saadcaffeine/dbdc/docs/related-projects.md

---
title: Related projects and products
nav_order: 6
---

# Related projects and products
{: .no_toc }

DBDC stands on the work of many others. Projects that publish designs or code openly are marked **Open source** and listed first. Prices are as published by the source given, on the date shown, and may have changed since.

1. TOC
{:toc}

## Open-source projects

| Project | What it is | What's open | Links |
|---|---|---|---|
| **BrailleRAP** <br>**Open source** | DIY braille **embosser** (paper) in the spirit of RepRap, developed with My Human Kit (France). Complements a display for printed braille. | Hardware and software | [Hackaday.io](https://hackaday.io/project/191085-braillerap-diy-braille-embosser), [My Human Kit wiki](https://wikilab.myhumankit.org/Projets:BrailleRap), [docs](https://braillerapsp-en.readthedocs.io/en/stable/history.html) |
| **Brailletouch: low-cost braille display** <br>**Open source** | One physical braille cell plus a 40-position touch matrix: the cell shows whichever virtual cell you touch. ESP32, 3D printed. Target about $100–150. | Electronics, firmware and designs on GitHub under its own Braille Touch Open and Community License (BTAC v1.2), which requires derivatives to stay open | [Hackaday.io](https://hackaday.io/project/182904-project-low-cost-braille-display), [GitHub](https://github.com/brailletouch/Brailletouch) |
| **Electromechanical Refreshable Braille Module** <br>**Files published** | Hackaday Prize 2023 entry: each dot is a 3D-printed bistable cam with a tiny magnet, flipped by a coil, so no power is needed to hold it. | CAD and Eagle files on Hackaday.io; licence not stated | [Hackaday.io](https://hackaday.io/project/191181-electromechanical-refreshable-braille-module) |
| **A Modular, Low Cost Braille Display System** <br>**Files published** | Hackaday Prize 2016 entry using tiny solenoids per dot | Project logs on Hackaday.io | [Hackaday.io](https://hackaday.io/project/12442-a-modular-low-cost-braille-display-system), [Hackaday article](https://hackaday.com/2016/07/09/hackaday-prize-entry-modular-low-cost-braille-display) |
| **Canute (Bristol Braille Technology)** <br>**Partly open source** | Multi-line braille e-reader (Canute 360, 9 lines × 40 cells) and the upcoming Canute Scientific workstation | Canute 360 reading software (canute-ui) is on GitHub under GPL-3.0. For Canute Scientific, the maker states that hardware files, firmware and BOM will be released before shipping; its Tactile Commons apps are GPL-3.0. | [canute-ui on GitHub](https://github.com/bristol-braille/canute-ui), [Canute Scientific on Crowd Supply](https://www.crowdsupply.com/bristol-braille-technology/canute-scientific), [Hackster article](https://www.hackster.io/news/the-open-source-canute-scientific-aims-for-parity-of-display-for-vision-impaired-scientists-cd24913621ab) |
| **BRLTTY** <br>**Open source** | Background service that gives braille display users access to the Linux/Unix console. It has a modular driver design, so a DBDC driver could be added. | Software | [brltty.app](https://brltty.app/) |
| **liblouis** <br>**Open source** | Braille translator and back-translator, contracted and uncontracted, for many languages; used by NVDA, Orca and JAWS | Software (LGPL) | [liblouis.io](https://liblouis.io/) |

## Research and prior art

| Work | Why it matters to DBDC |
|---|---|
| **NIST rotating-wheel braille display** (Roberts, Slattery and Kardos, 2000) | Moved the dots onto the rim of a spinning wheel, set by stationary actuators, so the reader's finger can stay still. The aim was a tenfold cost reduction compared with 80-cell displays then costing $10,000–15,000. DBDC shares the idea of putting the braille on a wheel, but uses one wheel per cell and encodes the patterns in the cam. [NIST publication](https://www.nist.gov/node/710926), [Wikipedia overview](https://en.wikipedia.org/wiki/Refreshable_braille_display) |
| **Jacques Mattheij's braille display notes** | Detailed open notes on low-cost mechanisms, including odometer-style wheels and a 64-position wheel covering all six-dot codes, with a target of about $5 per cell. Very relevant reading. [Notes](https://jacquesmattheij.com/refreshablebraille/BrailleDisplayProject.html) |
| **de Bruijn sequences** | The combinatorial structure that lets one rim hold every pattern exactly once. DBDC uses B(4,3) generated by the Fredricksen–Kessler–Maiorana algorithm. |

## Commercial displays

| Product | Maker | Cells | Technology | Price (source, date) |
|---|---|---|---|---|
| Orbit Reader 20 | Orbit Research / APH, with the Transforming Braille Group | 20 cells, 8-dot | Low-cost proprietary cell | $449 ([NFB Braille Monitor, Oct 2017](https://nfb.org/node/7598)) |
| Braille Me | Innovision (India), sold by National Braille Press | 20 cells, 6-dot | Magnetic actuation | $515.50 ([Perkins](https://www.perkins.org/resource/braille-me-and-orbit-reader-braille-display-comparison/)) |
| VarioUltra 20 | BAUM | 20 cells | Piezo | $2,395 ([NFB, 2017](https://nfb.org/node/7598)) |
| Braille Edge 40 | HIMS | 40 cells | Piezo | $2,795 ([NFB, 2017](https://nfb.org/node/7598)) |
| Canute 360 | Bristol Braille Technology | 9 lines × 40 cells | Hard-signage pins, multi-line | £2,495 RRP ([Bristol Braille](https://bristol-braille-website-8ad67c.gitlab.io/canute-360.html)) |
| Dot Pad | Dot Inc. | 2,400-pin graphics area + 20-cell line | Tactile graphics | £6,495 ex VAT ([RNIB shop](https://shop.rnib.org.uk/products/dot-pad)) |
| Monarch | APH and HumanWare | 10 lines × 32 cells (3,840 pins) | Tactile graphics + braille | $15,500 ([APH](https://aph.org/product/monarch)) |

Orbit Reader 20 and Braille Me show that cheaper cell mechanisms can bring 20-cell displays under about $520. Canute shows that multi-line mechanical displays can cost under £7 per cell. DBDC explores the same space with open hardware that can be made locally.
