saadcaffeine/dbdc/docs/position-table.md

---
title: Position table
nav_order: 4
---

# Position table

Disc position for each of the 64 six-dot braille patterns. The dot mask uses bit 0 for dot 1 through bit 5 for dot 6, the same order as Unicode braille (U+2800 + mask). The angle is the disc rotation from the home position (position 0, magnet at the bottom). The letter column shows uncontracted English letters a–z.

This table is generated by [`software/dbdc_table.py`](https://github.com/saadcaffeine/dbdc/blob/main/software/dbdc_table.py). Regenerate it rather than editing it by hand.

| Braille | Dots | Mask | Position | Angle | Letter |
|:---:|:---|---:|---:|---:|:---:|
| ⠀ | - | 0 | 1 | 5.625° |  |
| ⠁ | 1 | 1 | 5 | 28.125° | a |
| ⠂ | 2 | 2 | 6 | 33.750° |  |
| ⠃ | 12 | 3 | 23 | 129.375° | b |
| ⠄ | 3 | 4 | 7 | 39.375° |  |
| ⠅ | 13 | 5 | 25 | 140.625° | k |
| ⠆ | 23 | 6 | 24 | 135.000° |  |
| ⠇ | 123 | 7 | 57 | 320.625° | l |
| ⠈ | 4 | 8 | 2 | 11.250° |  |
| ⠉ | 14 | 9 | 8 | 45.000° | c |
| ⠊ | 24 | 10 | 20 | 112.500° | i |
| ⠋ | 124 | 11 | 26 | 146.250° | f |
| ⠌ | 34 | 12 | 16 | 90.000° |  |
| ⠍ | 134 | 13 | 34 | 191.250° | m |
| ⠎ | 234 | 14 | 46 | 258.750° | s |
| ⠏ | 1234 | 15 | 58 | 326.250° | p |
| ⠐ | 5 | 16 | 3 | 16.875° |  |
| ⠑ | 15 | 17 | 14 | 78.750° | e |
| ⠒ | 25 | 18 | 9 | 50.625° |  |
| ⠓ | 125 | 19 | 32 | 180.000° | h |
| ⠔ | 35 | 20 | 21 | 118.125° |  |
| ⠕ | 135 | 21 | 47 | 264.375° | o |
| ⠖ | 235 | 22 | 27 | 151.875° |  |
| ⠗ | 1235 | 23 | 59 | 331.875° | r |
| ⠘ | 45 | 24 | 11 | 61.875° |  |
| ⠙ | 145 | 25 | 17 | 95.625° | d |
| ⠚ | 245 | 26 | 29 | 163.125° | j |
| ⠛ | 1245 | 27 | 35 | 196.875° | g |
| ⠜ | 345 | 28 | 41 | 230.625° |  |
| ⠝ | 1345 | 29 | 53 | 298.125° | n |
| ⠞ | 2345 | 30 | 49 | 275.625° | t |
| ⠟ | 12345 | 31 | 61 | 343.125° | q |
| ⠠ | 6 | 32 | 4 | 22.500° |  |
| ⠡ | 16 | 33 | 22 | 123.750° |  |
| ⠢ | 26 | 34 | 15 | 84.375° |  |
| ⠣ | 126 | 35 | 45 | 253.125° |  |
| ⠤ | 36 | 36 | 0 | 0.000° |  |
| ⠥ | 136 | 37 | 19 | 106.875° | u |
| ⠦ | 236 | 38 | 33 | 185.625° |  |
| ⠧ | 1236 | 39 | 56 | 315.000° | v |
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
