saadcaffeine/dbdc/docs/assets/images/dbdc_disc.png

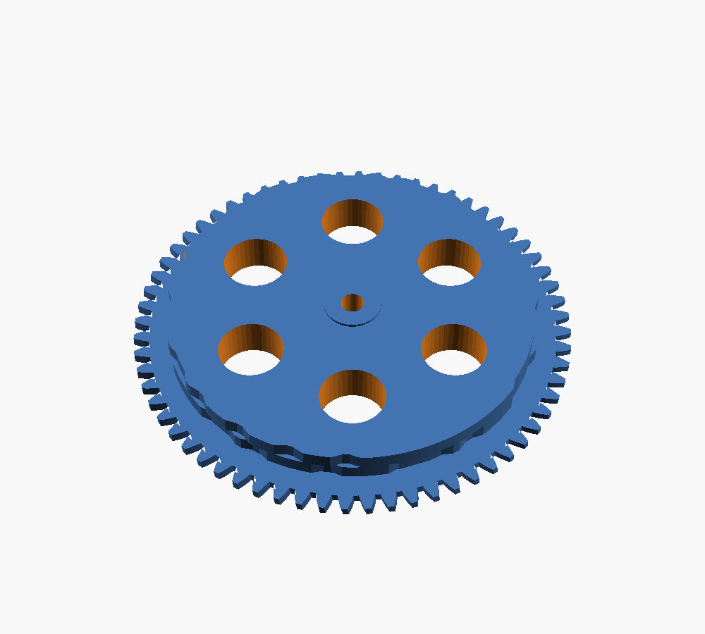
docs/assets/images/dbdc_disc.png
