saadcaffeine/dbdc/docs/assets/images/dbdc_worm.png

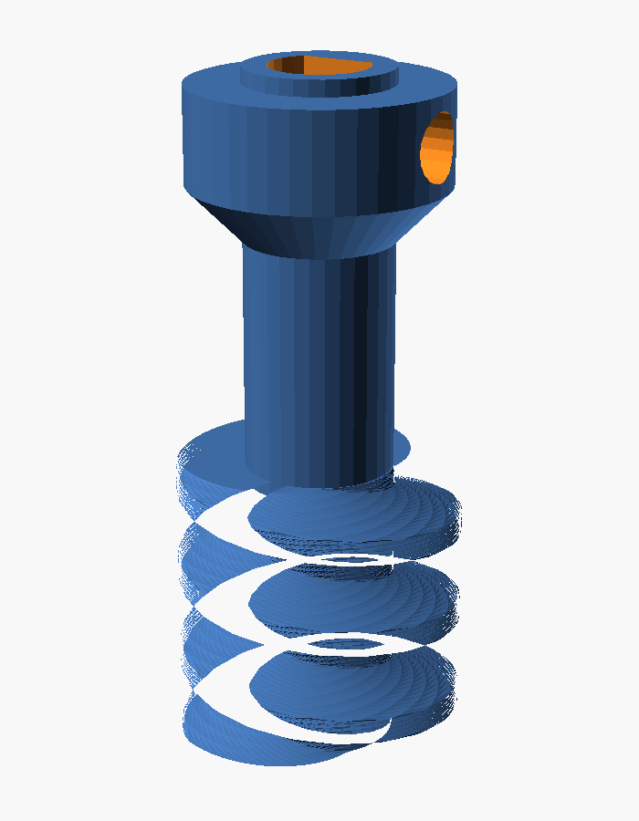
docs/assets/images/dbdc_worm.png
