saadcaffeine/dbdc/hardware/stl/dbdc_sensor_rail.stl

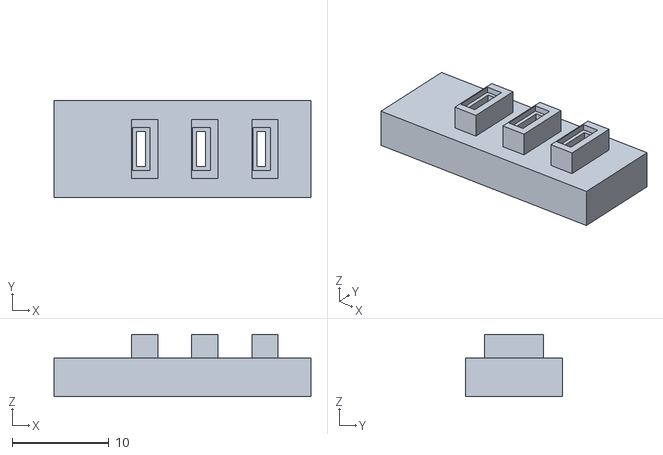
[picture p7: CAD file, 2026-11-02]
hardware/stl/dbdc_sensor_rail.stl
26.5 x 10.0 x 6.43
