saadcaffeine/dbdc/hardware/stl/dbdc_worm_front.stl

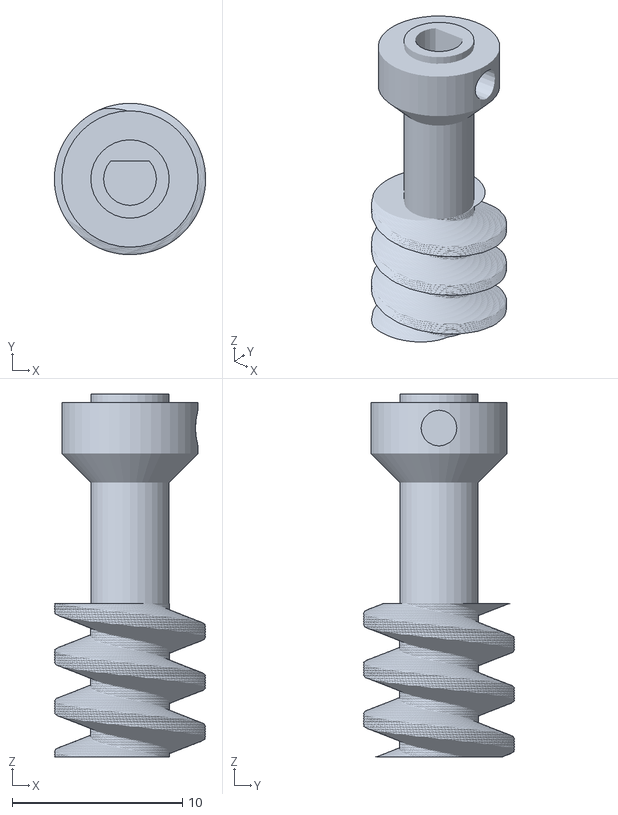
[picture p8: CAD file, 2026-11-02]
hardware/stl/dbdc_worm_front.stl
8.87 x 8.87 x 21.3
