saadcaffeine/dbdc/hardware/stl/dbdc_comb_front.stl

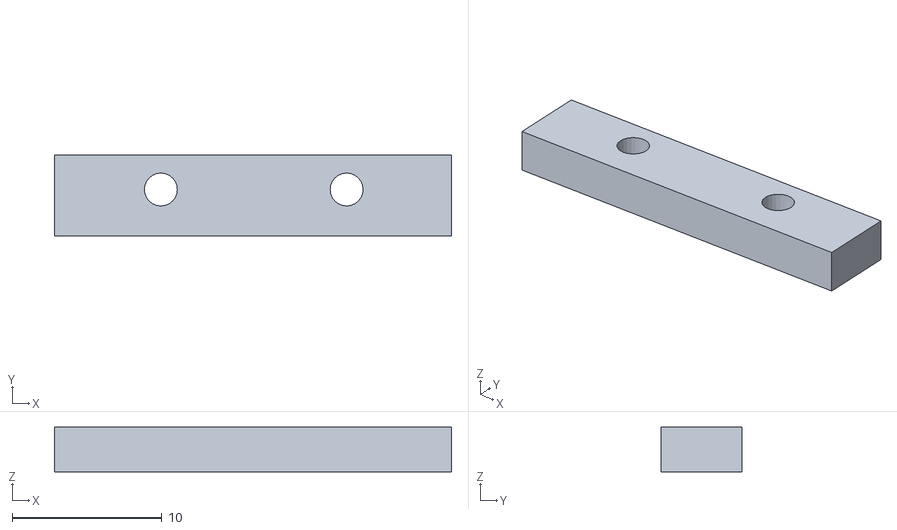
[picture p9: CAD file, 2026-11-02]
hardware/stl/dbdc_comb_front.stl
26.5 x 5.40 x 3.00
