saadcaffeine/dbdc/hardware/stl/dbdc_comb_back.stl

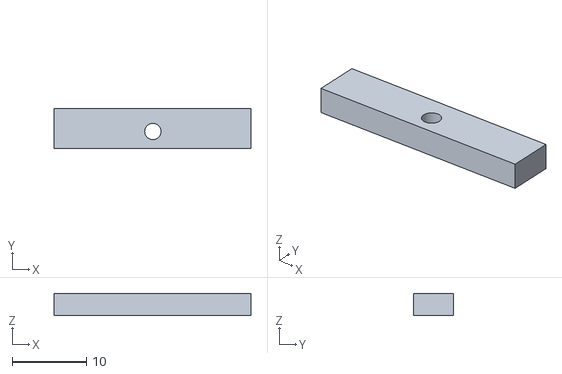
[picture p11: CAD file, 2026-11-02]
hardware/stl/dbdc_comb_back.stl
26.5 x 5.40 x 3.00
