saadcaffeine/dbdc/hardware/stl/dbdc_base.stl

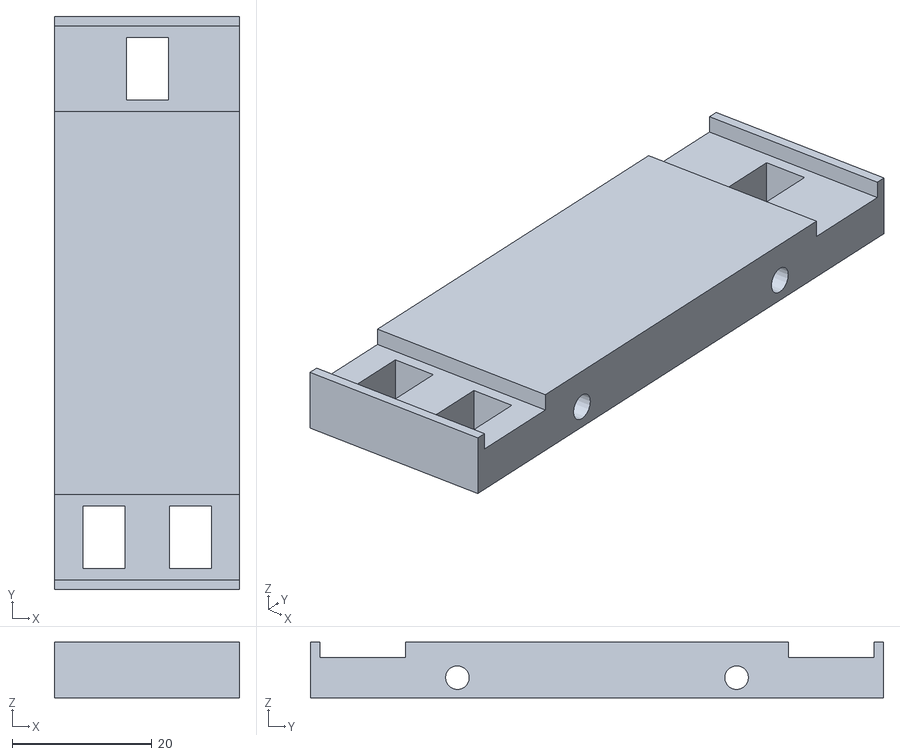
[picture p12: CAD file, 2026-11-02]
hardware/stl/dbdc_base.stl
26.5 x 82.1 x 8.00
