saadcaffeine/dbdc/hardware/stl/dbdc_panel_right.stl

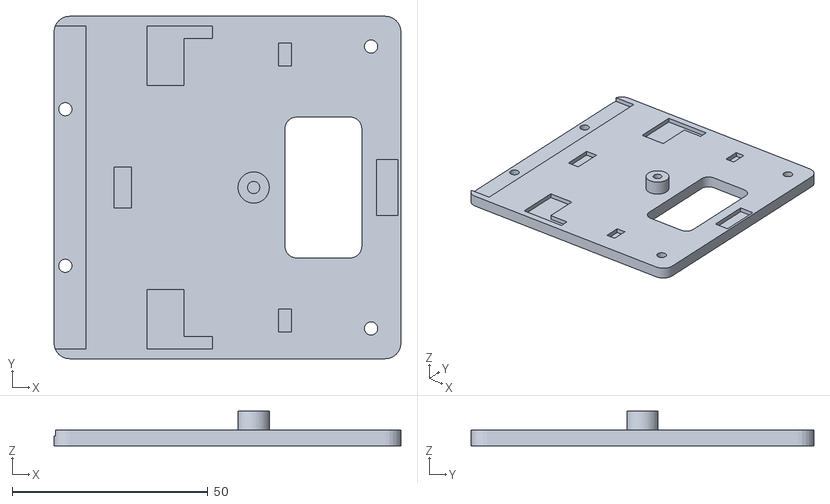
[picture p13: CAD file, 2026-11-02]
hardware/stl/dbdc_panel_right.stl
88.6 x 87.5 x 8.85
