saadcaffeine/dbdc/hardware/stl/dbdc_panel_left.stl

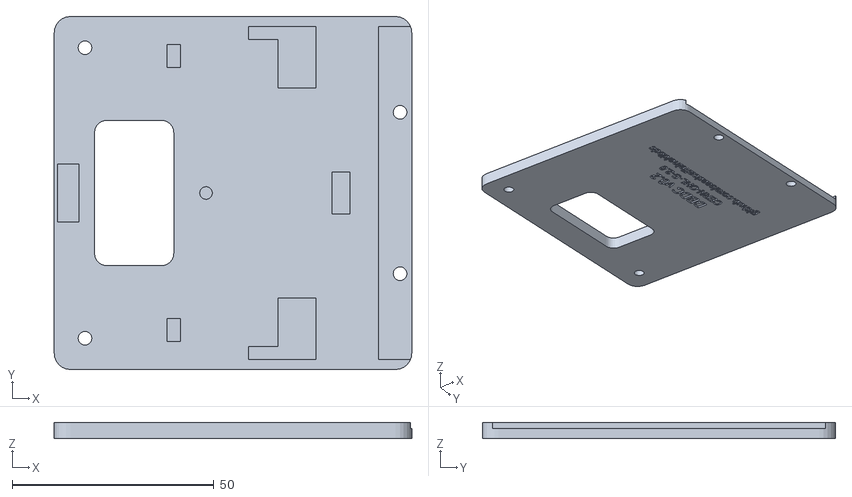
[picture p14: CAD file, 2026-11-02]
hardware/stl/dbdc_panel_left.stl
88.6 x 87.5 x 4.00
