saadcaffeine/dbdc/hardware/stl/dbdc_guide_plate.stl

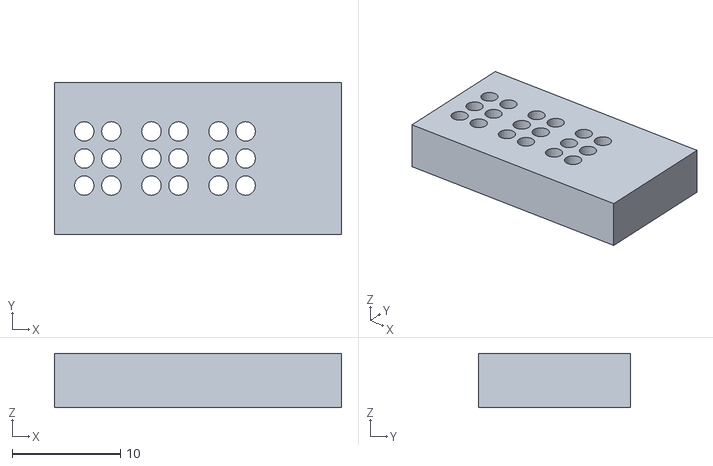
[picture p15: CAD file, 2026-11-02]
hardware/stl/dbdc_guide_plate.stl
26.5 x 14.0 x 5.00
