saadcaffeine/dbdc/hardware/stl/dbdc_rail_back.stl

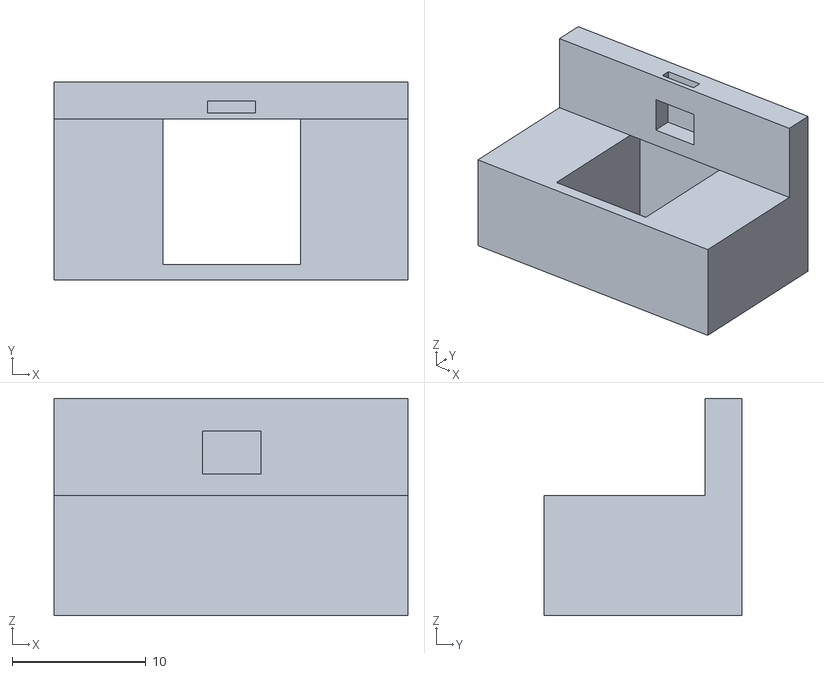
[picture p16: CAD file, 2026-11-02]
hardware/stl/dbdc_rail_back.stl
26.5 x 14.8 x 16.2
