saadcaffeine/dbdc/hardware/stl/dbdc_disc.stl

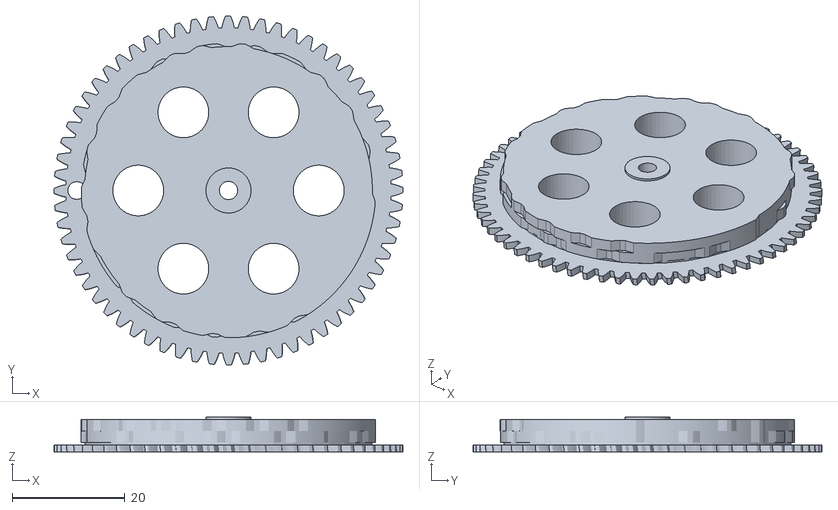
[picture p17: CAD file, 2026-11-02]
hardware/stl/dbdc_disc.stl
61.9 x 61.9 x 6.15
