saadcaffeine/dbdc/(list of files, cad)

Other CAD files:
hardware/stl/dbdc_worm_back.stl
hardware/cad/dbdc_3cell.scad
hardware/cad/history/03_worm_strip_4mm.scad
