saadcaffeine/dbdc/docs/assets/images/dbdc_panel_right_print.png

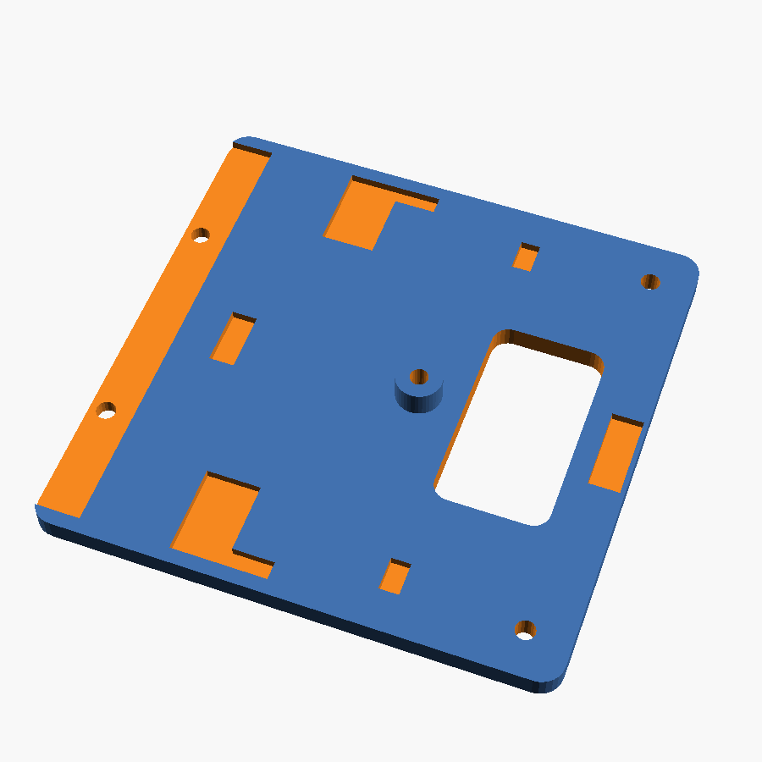
docs/assets/images/dbdc_panel_right_print.png
